hmg4321/MySmartWatch/WatchMe.docx

MySmartWatch

Device name: WatchMe

Device features:

- Heart Rate
- Pulse
- Blood pressure
- Respiration rate
- Body temperature
- ECG waveform?
