hmg4321/MySmartWatch/Hardware/Basic/Bottom/WatchMe-BASIC-BOTTOM.brd

## EAGLE design Hardware/Basic/Bottom/WatchMe-BASIC-BOTTOM.brd (2020-07-29)

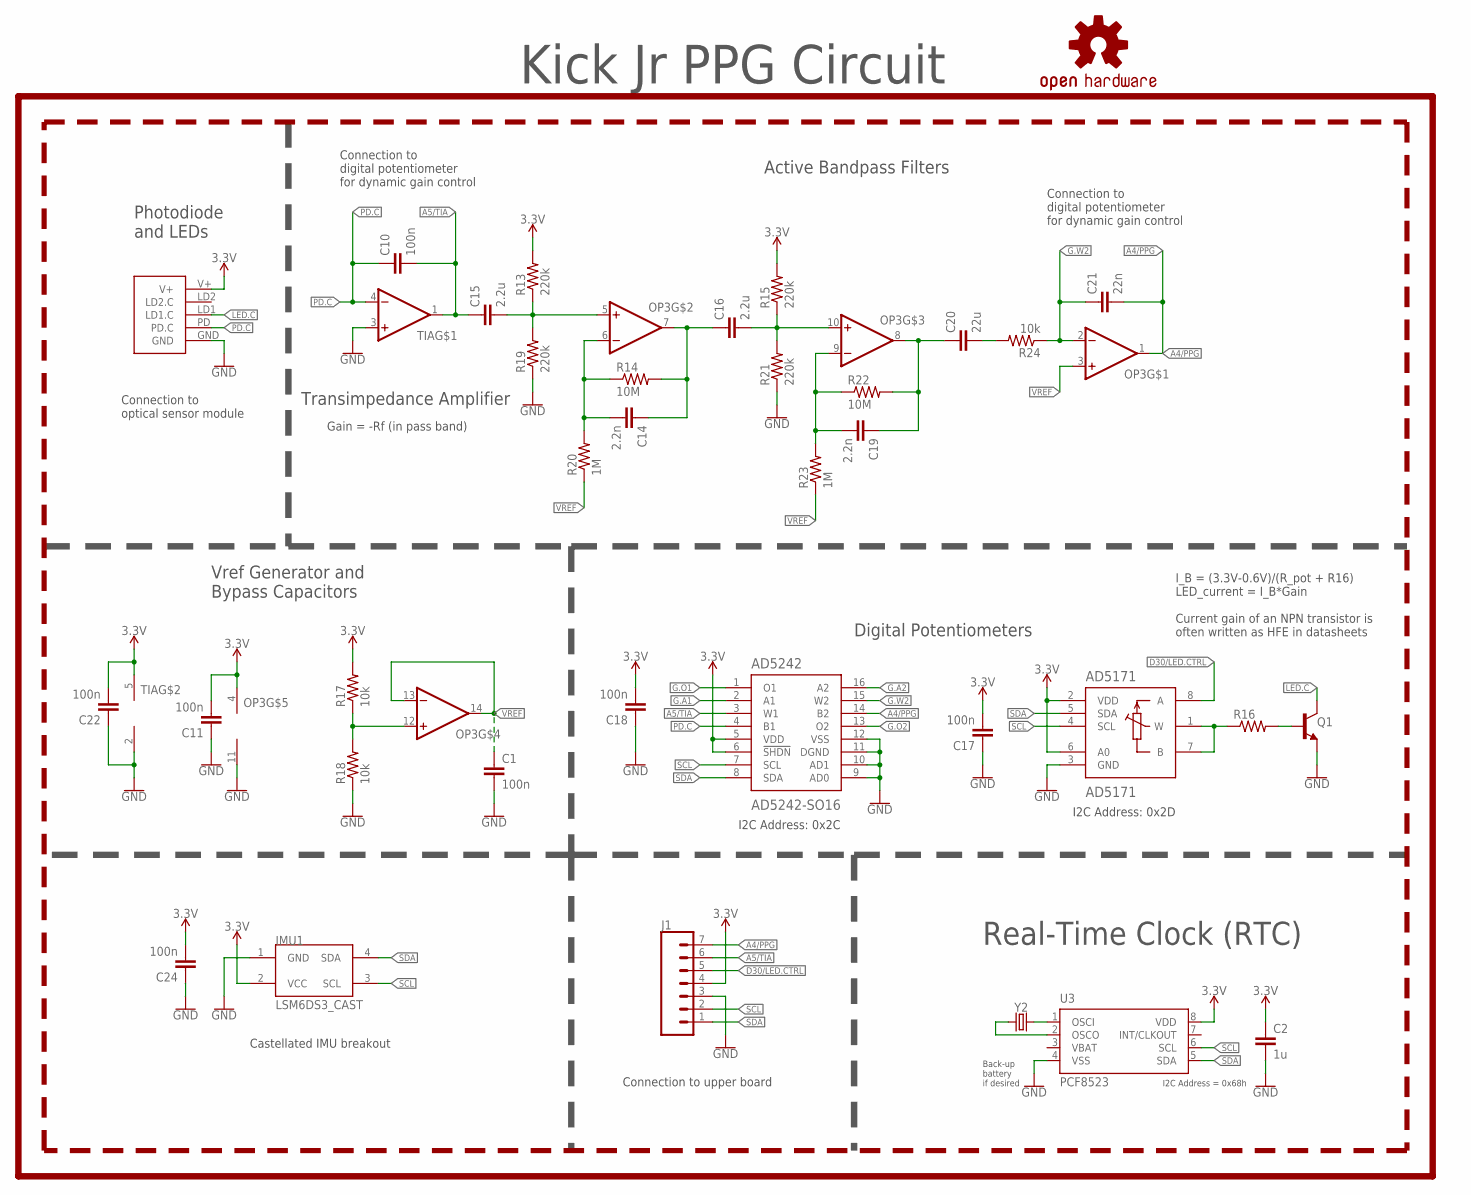
[picture p1: schematic WatchMe-BASIC-BOTTOM.sch]

Parts:
AD5171: AD5171; SOT-23-8
AD5242: AD5242-SO16; SO16
C1, C10, C11, C17, C18, C22, C24: 100n; C0603
C2: 1u; C0603
C14, C19: 2.2n; C0603
C15, C16: 2.2u; C0603
C20: 22u; C0603
C21: 22n; C0603
IMU1: LSM6DS3_CAST
J1: CONN_07-1.27MM; 1X07_1.27MM
LOGO1: REVISION.A; REV.A
LOGO2: OSHW-LOGOS; OSHW-LOGO-S
OP3: OP-QUAD-SO14; SO14
Q1: NPN-GENERIC; SOT23-3
R13, R15, R19, R21: 220k; R0603
R14, R22: 10M; R0603
R16: RESISTOR0603; R0603
R17, R18: 10k; R0402
R20, R23: 1M; R0603
R24: 10k; R0603
TIA: OP-SINGLEOT; SOT23-5
U3: PCF8523; SO8; DIGIKEY 568-5306-1-ND
U$3: PPG.MODULE.2
Y2: 32.7680kHz; 2-SMD.NOLEAD.2.0MMTO1.2MM

Connections:
3.3V: AD5171.2 (VDD), AD5171.6 (A0), AD5242.5 (VDD), AD5242.6 (!SHDN), C2.1, C11.2, C17.2, C18.2, C22.2, C24.2, IMU1.2 (VCC), J1.4, OP3.4 (V+), R13.2, R15.2, R17.2, TIA.5 (V+), U3.8 (VDD), U$3.V+
A4/PPG: AD5242.14 (B2), C21.2, J1.7, OP3.1 (OUT)
A5/TIA: AD5242.3 (W1), C10.2, C15.1, J1.6, TIA.1 (OUT)
D30/LED.CTRL: AD5171.8 (A), J1.5
G.A1: AD5242.2 (A1)
G.A2: AD5242.16 (A2)
G.O1: AD5242.1 (O1)
G.O2: AD5242.13 (O2)
G.W2: AD5242.15 (W2), C21.1, OP3.2 (-IN), R24.1
GND: AD5171.3 (GND), AD5242.9 (AD0), AD5242.10 (AD1), AD5242.11 (DGND), AD5242.12 (VSS), C1.2, C2.2, C11.1, C17.1, C18.1, C22.1, C24.1, IMU1.1 (GND), J1.3, OP3.11 (V-), Q1.2 (E), R18.1, R19.1, R21.1, TIA.2 (V-), TIA.3 (+IN), U3.4 (VSS), U$3.GND
LED.C: Q1.3 (C), U$3.LD1 (LD1.C)
unnamed: U3.1 (OSCI), Y2.P$2 (2)
unnamed: U3.2 (OSCO), Y2.P$1 (1)
unnamed: Q1.1 (B), R16.2
unnamed: AD5171.1 (W), AD5171.7 (B), R16.1
unnamed: OP3.12 (+IN), R17.1, R18.2
unnamed: C15.2, OP3.5 (+IN), R13.1, R19.2
unnamed: C14.2, OP3.6 (-IN), R14.1, R20.2
unnamed: C14.1, C16.1, OP3.7 (OUT), R14.2
unnamed: C16.2, OP3.10 (+IN), R15.1, R21.2
unnamed: C19.2, OP3.9 (-IN), R22.1, R23.2
unnamed: C19.1, C20.1, OP3.8 (OUT), R22.2
unnamed: C20.2, R24.2
PD.C: AD5242.4 (B1), C10.1, TIA.4 (-IN), U$3.PD (PD.C)
SCL: AD5171.4 (SCL), AD5242.7 (SCL), IMU1.3 (SCL), J1.2, U3.6 (SCL)
SDA: AD5171.5 (SDA), AD5242.8 (SDA), IMU1.4 (SDA), J1.1, U3.5 (SDA)
VBAT: U3.3 (VBAT)
VREF: C1.1, OP3.3 (+IN), OP3.13 (-IN), OP3.14 (OUT), R20.1, R23.1

Notes on the sheet:
Photodiode and LEDs
Active Bandpass Filters
Digital Potentiometers
Transimpedance Amplifier
I2C Address: 0x2C
I2C Address: 0x2D
Connection to optical sensor module
Connection to digital potentiometer for dynamic gain control
Connection to upper board
Castellated IMU breakout
Vref Generator and Bypass Capacitors
Kick Jr PPG Circuit
Real-Time Clock (RTC)
I2C Address = 0x68h
Back-up battery if desired
I_B = (3.3V-0.6V)/(R_pot + R16) LED_current = I_B*Gain Current gain of an NPN transistor is often written as HFE in datasheets
Gain = -Rf (in pass band)

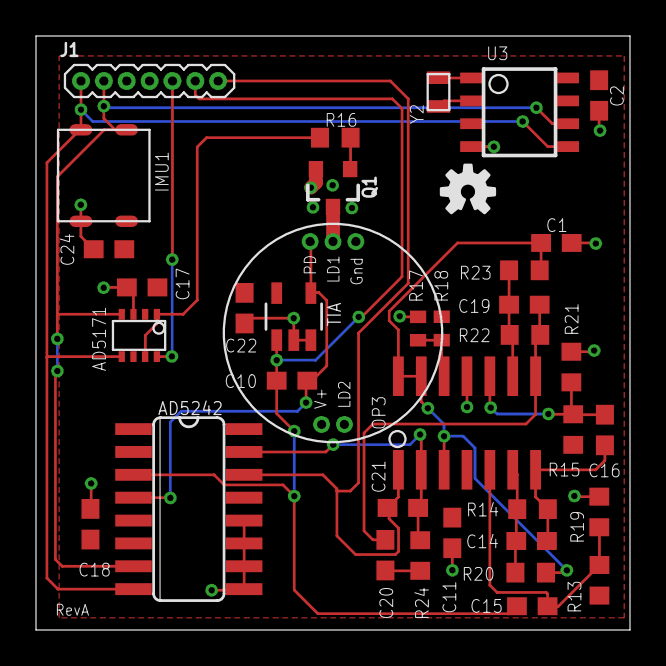
[picture p2: board WatchMe-BASIC-BOTTOM.brd from above]

Board: 2 copper layers, 33.0 x 33.0 mm, 38 parts (0 on the bottom side), 23 nets.
