hmg4321/MySmartWatch/(commit log)

2020-07-01 adding folder structures
    [WatchMe-BASIC-AUX1-BOM.xlsx, WatchMe-BASIC-AUX2-BOM.xlsx, WatchMe-BASIC-BOTTOM-BOM.xlsx, WatchMe-BASIC-PPG-MODULE-BOM.xlsx, WatchMe-BASIC-TOP-BOM.xlsx]
2020-07-08 update 1
    [WatchMe-BASIC-BOTTOM.brd, WatchMe-BASIC-BOTTOM.sch, WatchMe-BASIC-PPG-MODULE.brd, WatchMe-BASIC-PPG-MODULE.sch, WatchMe-BASIC-TOP.brd, WatchMe-BASIC-TOP.sch]
2020-07-09 updated top brd/sch
    [WatchMe-BASIC-TOP.brd, WatchMe-BASIC-TOP.sch]
2020-07-14 updated top board/sch
    [WatchMe-BASIC-TOP.brd, WatchMe-BASIC-TOP.sch]
2020-07-14 updated top board/sch again
    [WatchMe-BASIC-TOP_withtempsensor.brd, WatchMe-BASIC-TOP_withtempsensor.sch]
2020-07-16 continuin top board work
    [WatchMe-BASIC-TOP.brd, WatchMe-BASIC-TOP.sch]
2020-07-21 updated top board, still pretty chaotic
    [WatchMe-BASIC-TOP.brd]
2020-07-21 top board routing complete
    [WatchMe-BASIC-TOP.brd]
2020-07-21 Added LSM6DS3 sensor
    [WatchMe-BASIC-TOP.brd, WatchMe-BASIC-TOP.sch]
2020-07-22 Beginning to resolve DRC errors
    [WatchMe-BASIC-TOP.brd]
2020-07-22 removed LSM6DS3 sensor - already on bottom board
    [WatchMe-BASIC-TOP.brd, WatchMe-BASIC-TOP.sch]
2020-07-28 fixed all DRC errors/warnings
    [WatchMe-BASIC-TOP.brd]
2020-07-28 fixed remaining warnings
    [WatchMe-BASIC-TOP.brd, WatchMe-BASIC-TOP_withtempsensor.brd, WatchMe-BASIC-TOP_withtempsensor.sch]
2020-07-29 updated bottom and PPG boards
    [WatchMe-BASIC-BOTTOM.brd, WatchMe-BASIC-BOTTOM.sch, WatchMe-BASIC-PPG-MODULE-BOM.xlsx, WatchMe-BASIC-PPG-MODULE.brd, WatchMe-BASIC-PPG-MODULE.sch]
